jhynes94/NFC-Wearable/NFC Wearable.pdf

# PROG uController

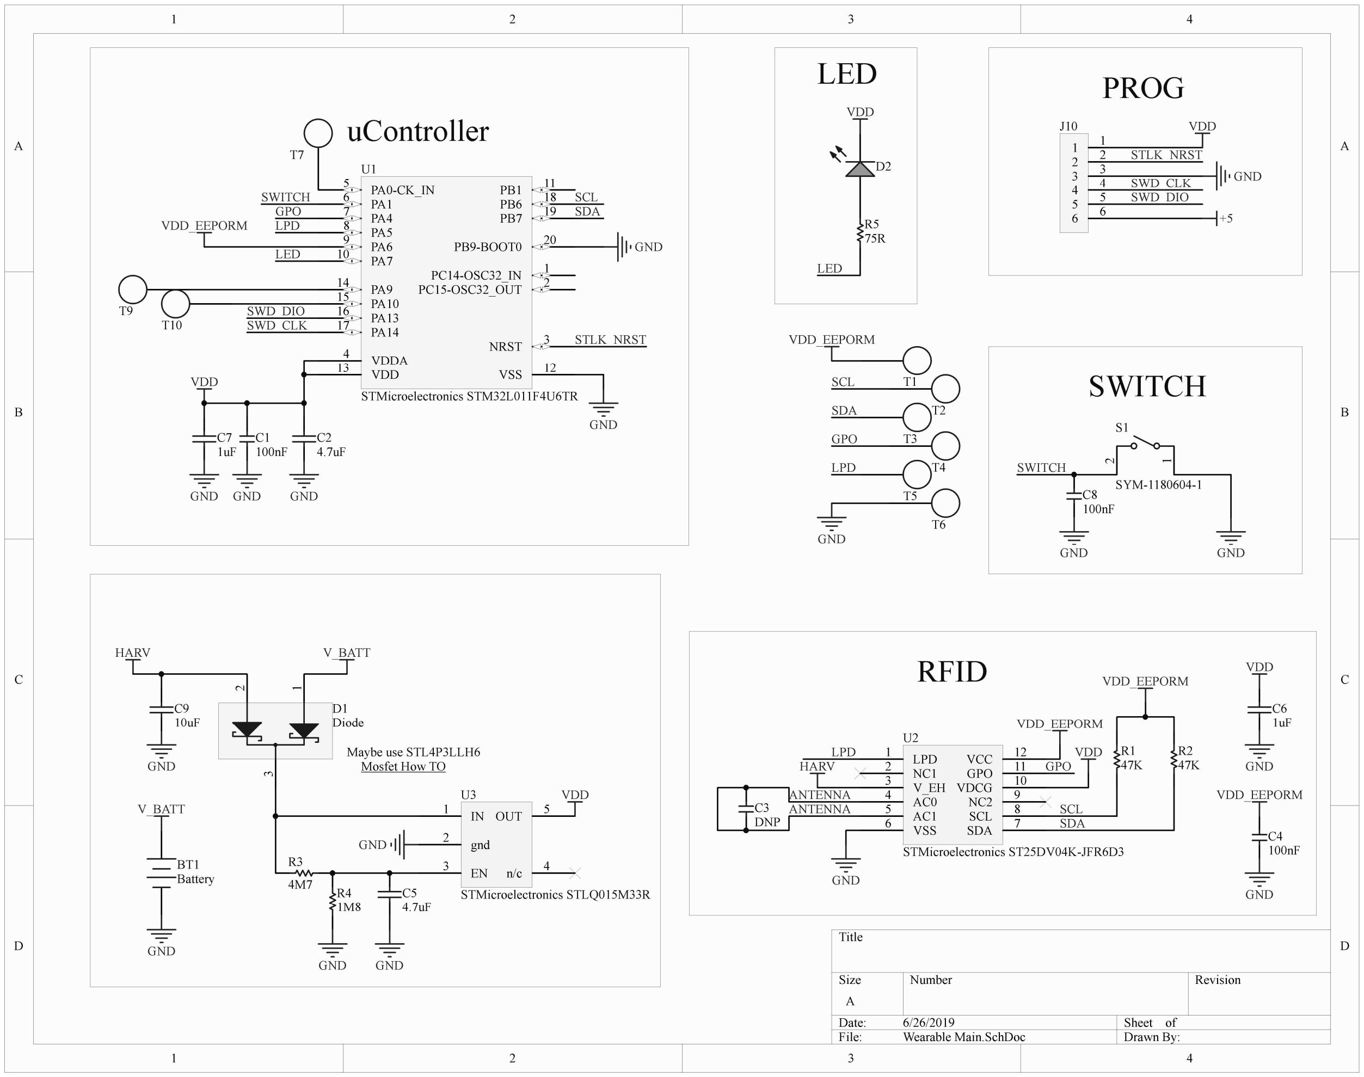
[picture p2: page 1]

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
Title

Size | Number | Revision
A
Date: | 6/26/2019 | Sheet of
File: | Wearable Main.SchDoc | Drawn By:
PC14-OSC32_IN | 1
PC15-OSC32_OUT | 2
NRST | 3
VDDA 4

PA0-CK_IN 5
PA1 6
PA4 7
PA5 8
PA6 9
PA7 10
PB1 | 11
VSS | 12 VDD 13

PA9 14
PA10 15
PA13 16
PA14 17
PB6 | 18
PB7 | 19
PB9-BOOT0 | 20

U1

STMicroelectronics STM32L011F4U6TR | 2

1

S1

SYM-1180604-1

BT1
Battery

GND

V_BATT
SDA

SCL IN 1

gnd 2

EN 3

n/c | 4
OUT | 5

U3

STMicroelectronics STLQ015M33R

2

1

3

D1
Diode

4.7uF

C5

GND

1M8

R4 4M7

R3

GND

HARV | V_BATT

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
VDD_EEPORM

47K

R2

100nF

C4

VDD_EEPORM

GND

# RFID

SDA

SCL

VDD
GPO

VDD_EEPORM

ANTENNA
ANTENNA
DNP

C3

HARV

LPD

1uF

C6

VDD

GND LPD 1
NC1 2
V_EH 3
AC0 4
AC1 5
VSS 6
VCC | 12
GPO | 11
VDCG | 10
NC2 | 9
SCL | 8
SDA | 7

U2

STMicroelectronics ST25DV04K-JFR6D3

Maybe use STL4P3LLH6

VDD

GND GND

STLK_NRST

GND

GND LED

100nF

C1
1uF

C7

SWD_CLK

SWD_DIO

GND

VDD

100nF

C8

GND | GND

SWITCH

SWITCH

# SWITCH

+5

4.7uF

C2

10uF

C9

D2

# LED

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
VDD_EEPORM

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
VDD_EEPORM

GPO
LPD

SWD_CLK
SWD_DIO

STLK_NRST

Mosfet How TO
