jhynes94/NFC-Wearable/Firmware/NFC_Project/Src/main.c

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

/* Includes ------------------------------------------------------------------*/
#include "main.h"
#include "i2c.h"
#include "gpio.h"


void SystemClock_Config(void);
/* USER CODE BEGIN 0 */

void writeNFC(uint16_t deviceAddress, uint16_t registerAddress, uint8_t data){
	uint8_t buffer[3] = {0};

	buffer[0] = registerAddress>>8; //Register Address MSB
	buffer[1] = registerAddress; //Register Address LSB
	buffer[2] = data; //Date to Write
	HAL_I2C_Master_Transmit(&hi2c1, deviceAddress<<1, buffer, 3, 10);
}

uint8_t readNFC(uint16_t deviceAddress, uint16_t registerAddress){
	uint8_t buffer[2] = {0};

	buffer[0] = registerAddress>>8; //Register Address MSB
	buffer[1] = registerAddress; //Register Address LSB
	HAL_I2C_Master_Transmit(&hi2c1, deviceAddress<<1, buffer, 2, 10); //Choose Register

	buffer[0] = 0;
	buffer[1] = 0;
	HAL_I2C_Master_Receive(&hi2c1, deviceAddress<<1, buffer, 1, 10); //Read Byte

	return(buffer[0]);
}

void addToOpenings(){
	  //Read from I2C device information
	  HAL_GPIO_WritePin(GPIOA, VDD_EEPROM_Pin, GPIO_PIN_SET); //Give Power to ST25 EEPROM
	  HAL_Delay(10); //Wait for EEPROM to power up

	  uint16_t deviceAddress = 0b1010011;
	  //deviceAddress = 0b1010111;
	  /*
	  I2C device found at address 0x2D  !
	  I2C device found at address 0x53  !
	  I2C device found at address 0x57  !
	  */

	//Check if I2C Device is Valid
	if(HAL_I2C_IsDeviceReady(&hi2c1, deviceAddress<<1, 2, 10) == HAL_OK){

		uint8_t data = 0;
		uint16_t regAdd = 0;

		data = readNFC(deviceAddress, regAdd);
		HAL_Delay(20);
		data++;
		writeNFC(deviceAddress, regAdd, data);
	}
}

void zeroOpenings(){

	HAL_GPIO_WritePin(GPIOA, VDD_EEPROM_Pin, GPIO_PIN_SET); //Give Power to ST25 EEPROM
	HAL_Delay(10); //Wait for EEPROM to power up
	uint16_t deviceAddress = 0b1010011;


	//Check if I2C Device is Valid
	if(HAL_I2C_IsDeviceReady(&hi2c1, deviceAddress<<1, 2, 10) == HAL_OK){
		uint8_t data = 0;
		uint16_t regAdd = 0;
		writeNFC(deviceAddress, regAdd, data);
	}
}

/* USER CODE END 0 */

/**
  * @brief  The application entry point.
  * @retval int
  */
int main(void)
{
  

  /* MCU Configuration--------------------------------------------------------*/

  /* Reset of all peripherals, Initializes the Flash interface and the Systick. */
  HAL_Init();

  /* Configure the system clock */
  SystemClock_Config();

  /* Initialize all configured peripherals */
  MX_GPIO_Init();
  MX_I2C1_Init();
  /* Infinite loop */
  /* USER CODE BEGIN WHILE */
  uint8_t flop = 0;
  zeroOpenings();
  while (1)
  {
    /* USER CODE END WHILE */

    /* USER CODE BEGIN 3 */

      if (HAL_GPIO_ReadPin(SWITCH_GPIO_Port, SWITCH_Pin) == 0 && flop == 0)
      {
          // Turn on LED on PA0 (LED circuit is active low)
    	  HAL_GPIO_WritePin(LED_GPIO_Port, LED_Pin, GPIO_PIN_RESET);
    	  flop = 1;

    	  addToOpenings();
      }
      if (HAL_GPIO_ReadPin(SWITCH_GPIO_Port, SWITCH_Pin) == 1 && flop == 1)
      {
          // Turn off LED on PA0
    	  HAL_GPIO_WritePin(LED_GPIO_Port, LED_Pin, GPIO_PIN_SET);
    	  flop = 0;
      }

/*
      if (HAL_GPIO_ReadPin(GPO_GPIO_Port, GPO_Pin) == 1)
      {
          // Turn on LED on PA0 (LED circuit is active low)
    	  HAL_GPIO_WritePin(LED_GPIO_Port, LED_Pin, GPIO_PIN_RESET);
    	  HAL_Delay(1000);
      }*/

      //HAL_Delay(100);

  }
  /* USER CODE END 3 */
}

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
