jhynes94/NFC-Wearable/(commit log)

2019-06-26 Reed Switch Controls LED
2019-07-02 Added Schematic
